ShashwathSundar/DIY-Drum-Machine/Analog_Drum_Machine_Schematic.pdf

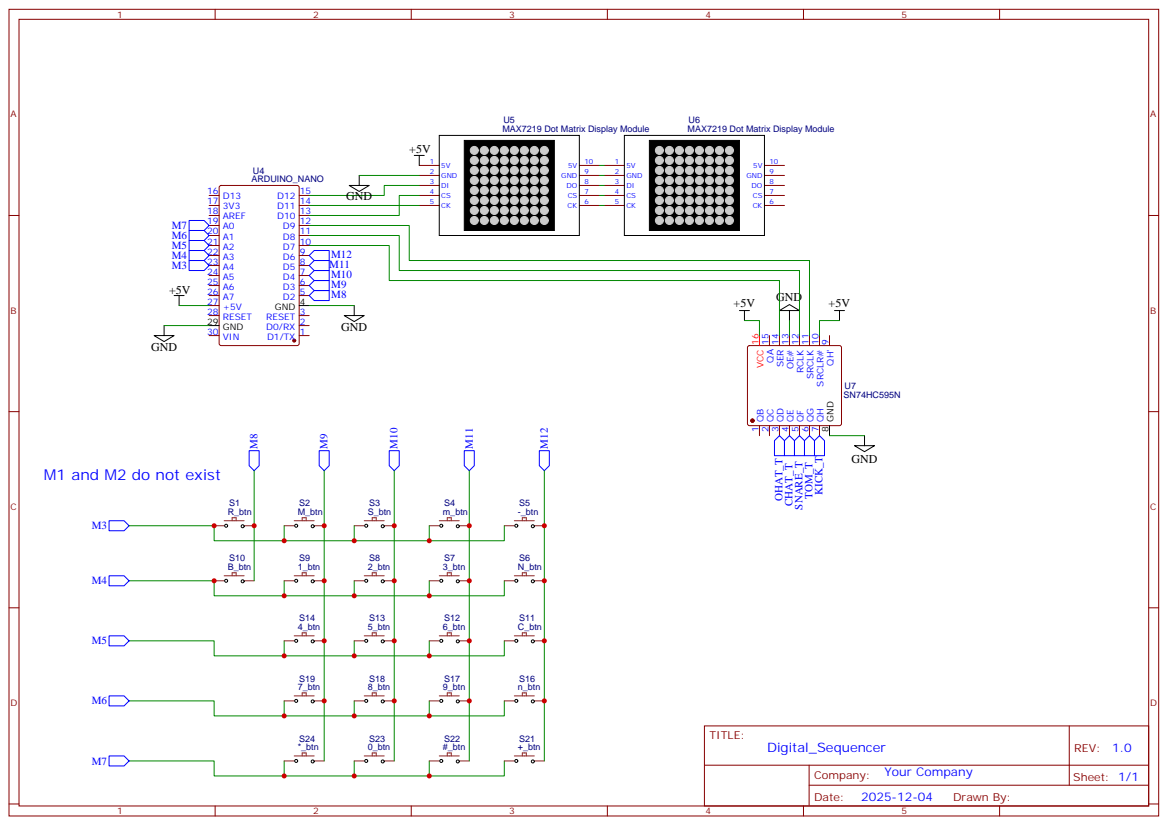
[picture p7: page 1]

MAX7219 Dot Matrix Display Module

9 SRCLR# 10 SRCLK 11 RCLK 12 OE# 13 SER 14 QA 15 VCC 16

M1 and M2 do not exist

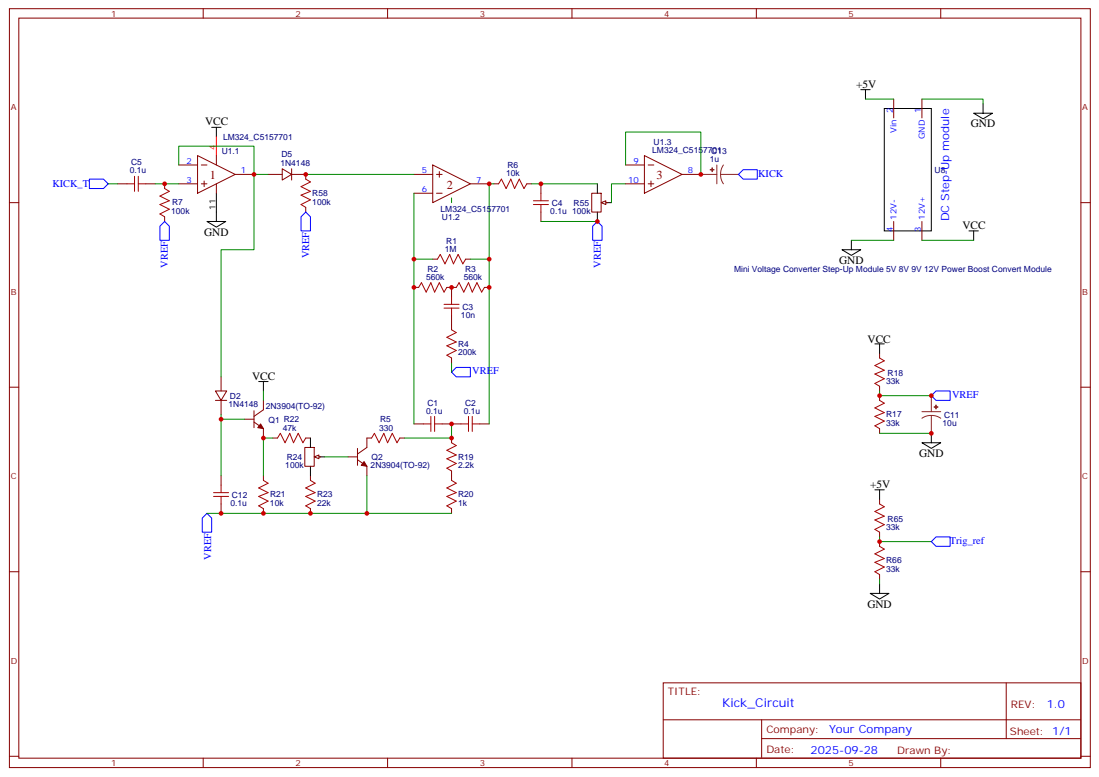
[picture p8: page 2]

DC Step-Up module
GND

Mini Voltage Converter Step-Up Module 5V 8V 9V 12V Power Boost Convert Module




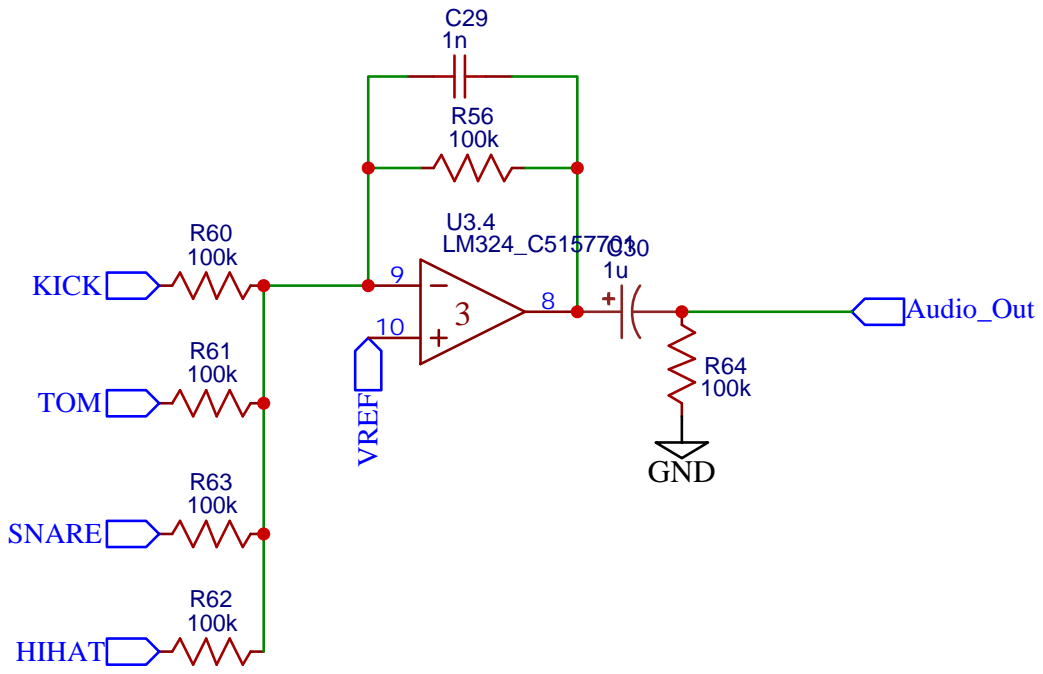
[picture p9: page 6]
