ShashwathSundar/DIY-Drum-Machine/(commit log)

2025-12-05 Add files via upload
    Drum Machine Schematics
2025-12-05 Add files via upload
    Drum Machine Schematic
2025-12-21 Add files via upload
    updated kick drum schematic
2026-05-25 Add files via upload
    Drum machine schematic with MIDI input
